Scorpion160/Electronic-Development-board/figures/pcb_face_top.png

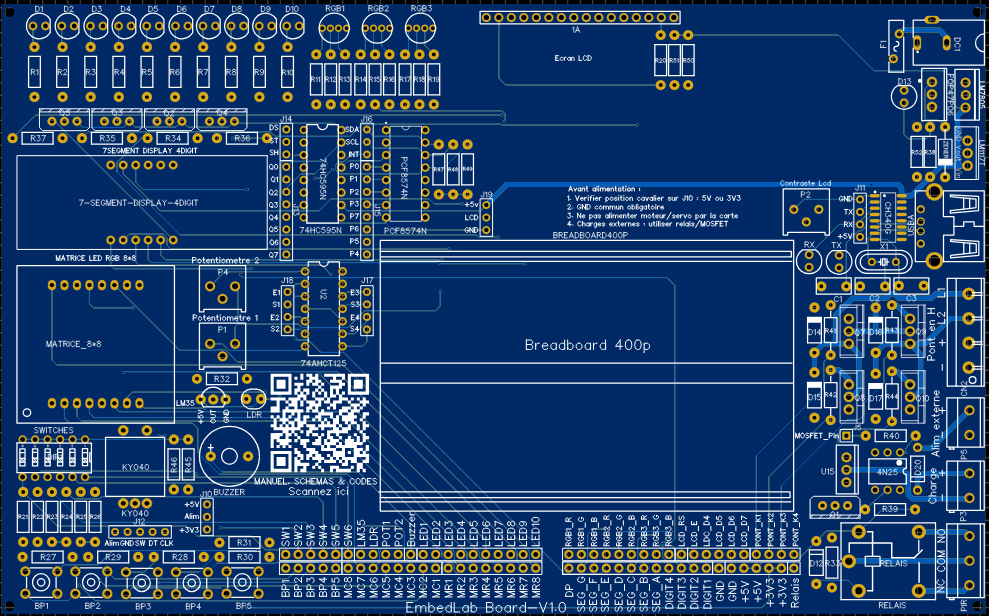
figures/pcb_face_top.png
