Scorpion160/Electronic-Development-board/figures/schema_pcb.png

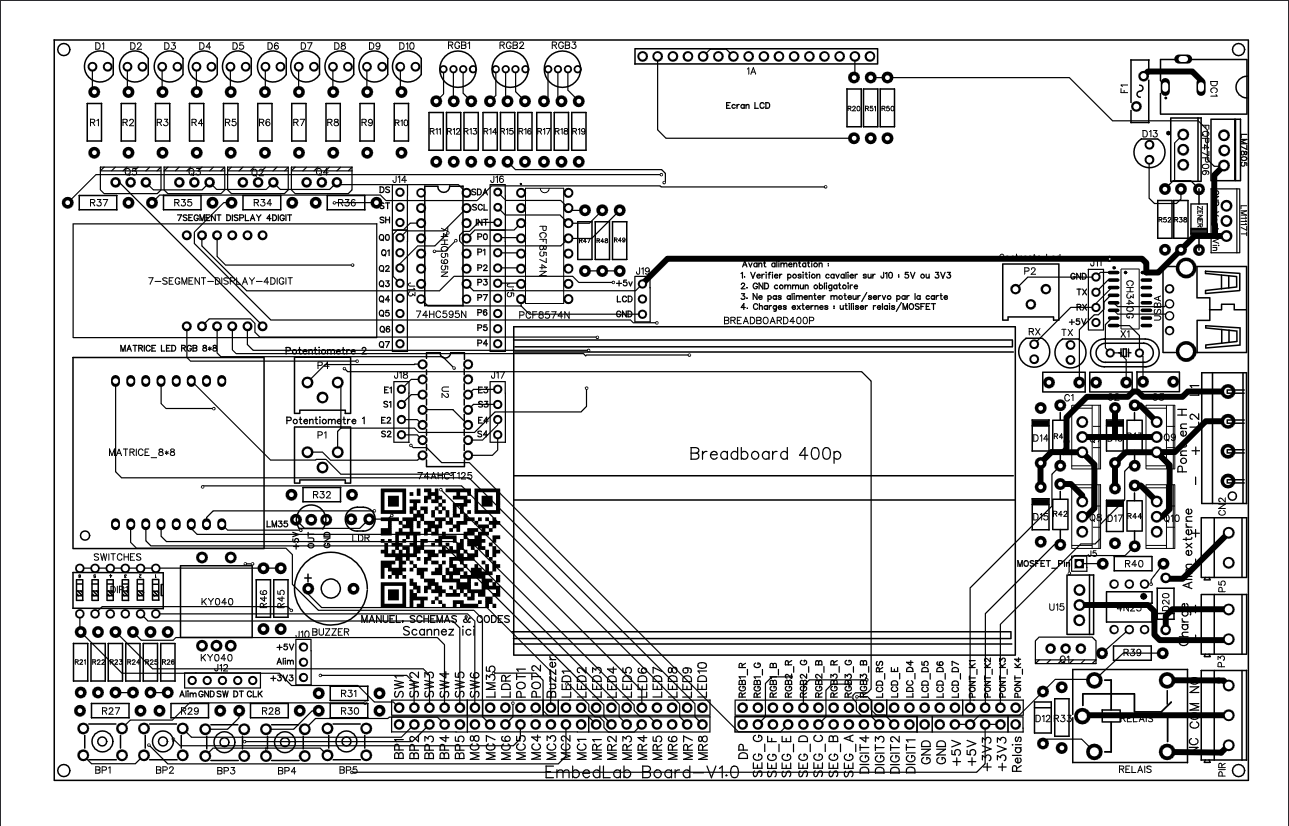
figures/schema_pcb.png
