Scorpion160/Electronic-Development-board/figures/vue_3d_non_annotee.png

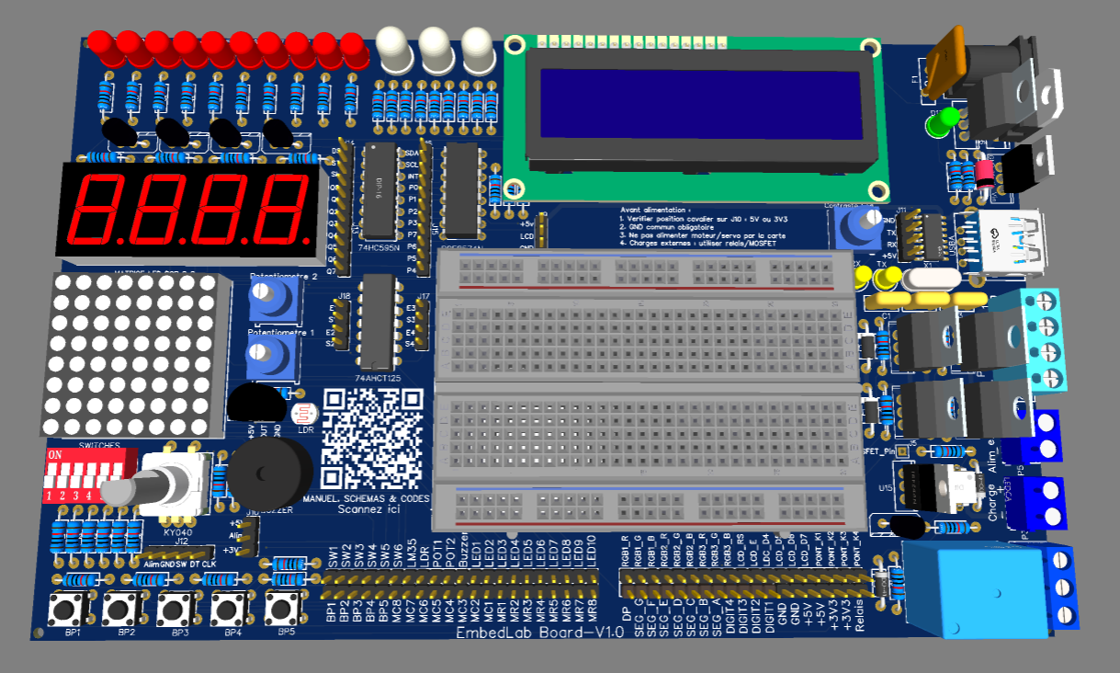
figures/vue_3d_non_annotee.png
