Scorpion160/Electronic-Development-board/render/datasheet-1.png

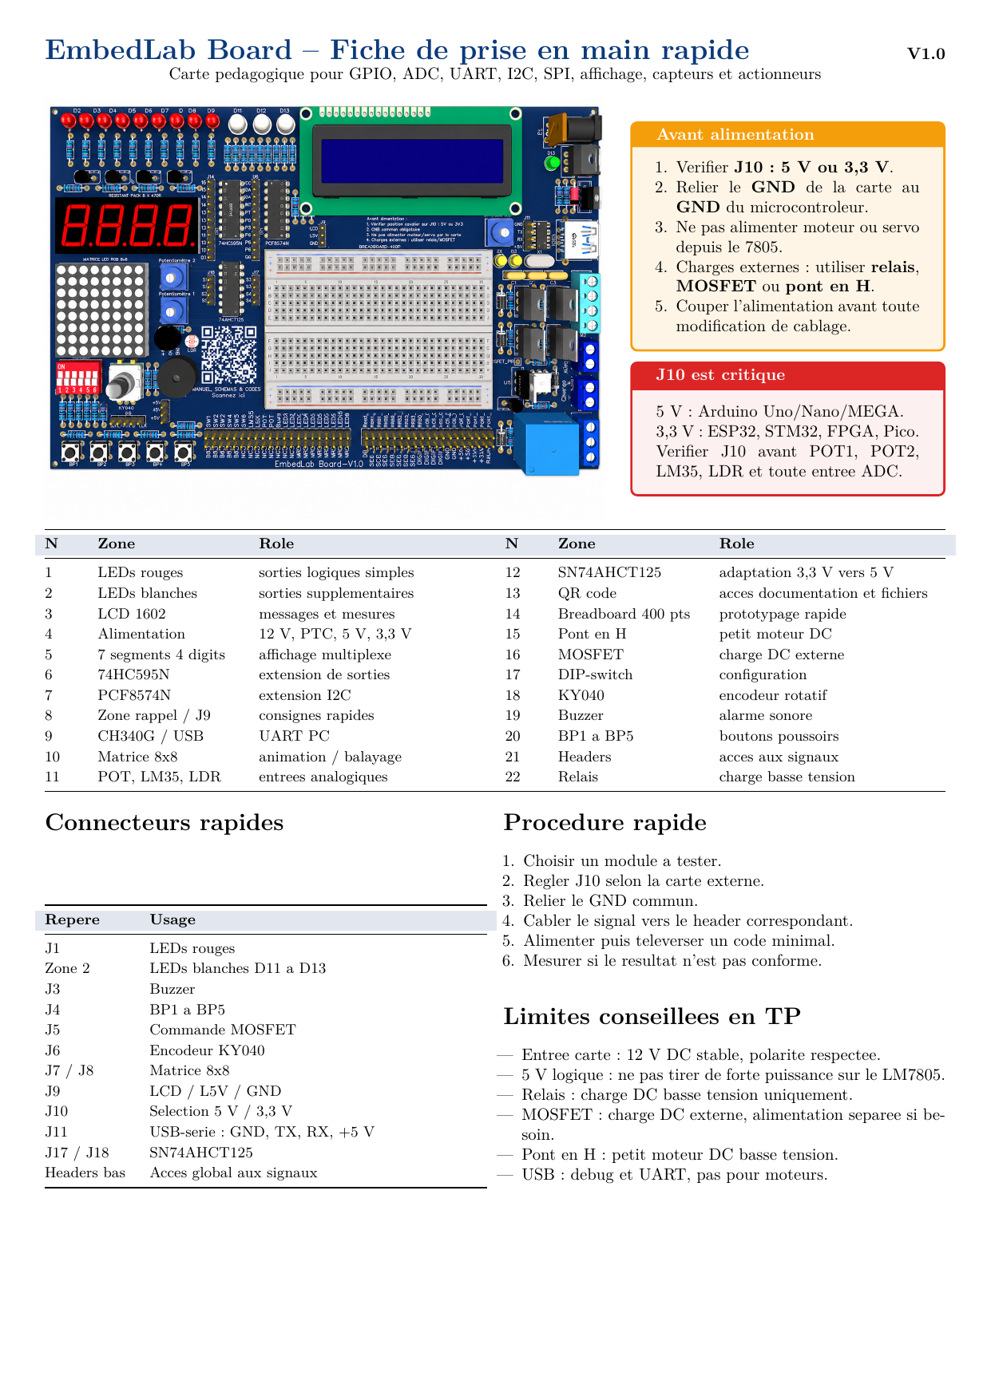
render/datasheet-1.png
