Scorpion160/Electronic-Development-board/render/datasheet-2.png

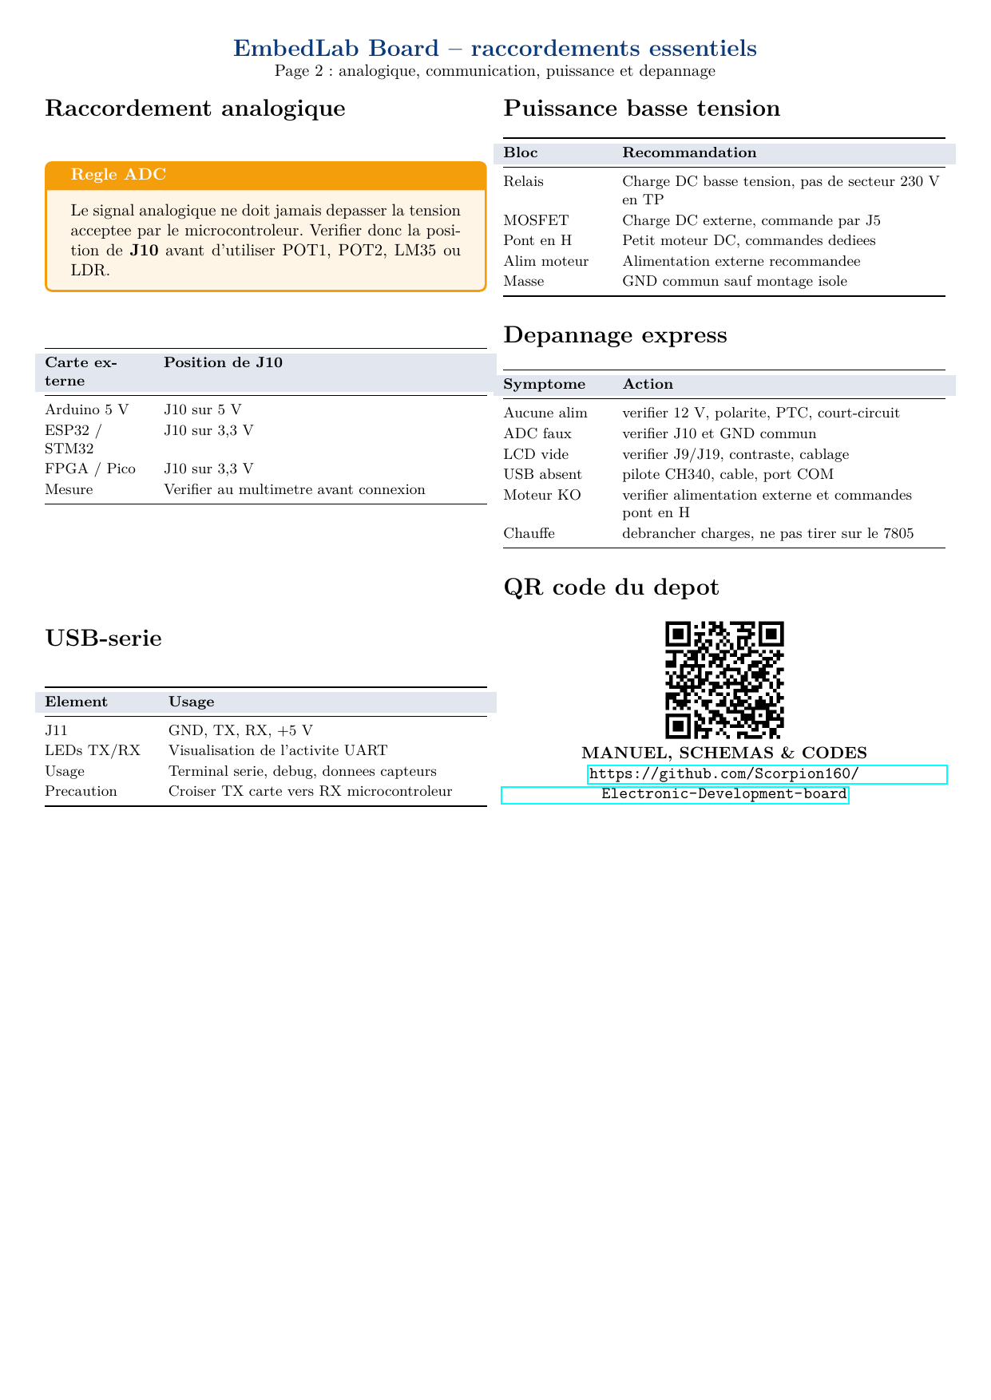
render/datasheet-2.png
