Scorpion160/Electronic-Development-board/hardware/bom/BOM_Carte-de-developpement_2026-06-07.csv

ID | Name | Designator | Footprint | Quantity | Manufacturer Part | Manufacturer | Supplier | Supplier Part | Price | Pins | 3DModel | Add into BOM | Assembly Type | Contributor | Convert to PCB | JLCPCB Part Class | LCSC Assembly | Package Display | Paste Type | SMT Type | Value | Voltage | description | image | license | link
1 | sn74ahct125 | U2 | SN74AHCT125 | 1 |  |  |  |  |  | 14 | SN74AHCT125N/3D/SN74AHCT125N |  |  | jlozon
2 | RGB1 | RGB1 | LED RGB 5MM (ARL5RGB) | 1 |  |  |  |  |  | 4 | LED_D5.0mm-4_RGB |  |  | lehanedonater
3 | RGB2 | RGB2 | LED RGB 5MM (ARL5RGB) | 1 |  |  |  |  |  | 4 | LED_D5.0mm-4_RGB |  |  | lehanedonater
4 | RGB3 | RGB3 | LED RGB 5MM (ARL5RGB) | 1 |  |  |  |  |  | 4 | LED_D5.0mm-4_RGB |  |  | lehanedonater
5 | LED power | D13 | LED_GREEN 5MM | 1 |  |  |  |  |  | 2 |  |  |  | apps1974z
6 | ZL-DCY12075-2705P-7.6 | BUZZER | BUZZER-R6.0-2P-7.6MM | 1 | ZL-DCY12075-2705P-7.6 | ZLFY | LCSC | C194535 | 0.36 | 2 | Buzzer_Beeper.3dshapes/MagneticBuzzer_ProSignal_ABT-410-RC |  |  | jverban
7 | MATRICE_LED_RGB_8*8 | MATRICE_8*8 | MATRICE_8*8 | 1 |  |  |  |  |  | 16 | 8X8 LED MATRIX 3D |  |  | Immelmann75
8 | Led_RED | D1,D2,D3,D4,D5,D6,D7,D8,D9,D10 | LED_GREEN 5MM | 10 |  |  |  |  |  | 2 | LED-TH-5MM_RED |  |  | apps1974z
9 | RX_LED | RX | LED_GREEN 5MM | 1 |  |  |  |  |  | 2 | led-yellow-th |  |  | apps1974z
10 | TX_LED | TX | LED_GREEN 5MM | 1 |  |  |  |  |  | 2 | led-yellow-th |  |  | apps1974z
11 | 12MHz | X1 | HC-49S_L11.5-W4.7-P4.88 | 1 | H1OEL89CSC-SUGYLC-12M | YXC(扬兴晶振) | LCSC | C7471636 | 0.083 | 2 | HC-49S_L11.5-W4.7-P4.88 |  |  | lcsc |  | Extended Part |  |  |  |  |  |  |  |  |  | https://atta.szlcsc.com/upload/public/pdf/source/20210508/C1669874_64E549CF07F5086D89FFFF9B4EA95FB8.pdf
12 | 220 | R50,R51,R1,R2,R3,R4,R5,R6,R7,R8,R9,R10,R11,R12,R17,R20,R38,R40 | RESISTANCE | 18 |  |  |  |  |  | 2 |  |  |  | Shraifk
13 | 4N25 | 4N25 | 4N25-OPTO | 1 |  |  |  |  |  | 6 |  |  |  | patpiz
14 | 7-SEGMENT-DISPLAY-4DIGIT | 7-SEGMENT-DISPLAY-4DIGIT | 7-SEGMENT-DISPLAY-4DIGIT | 1 |  |  |  |  |  | 12 | 4-digit-7segment-display |  |  | supinder1788
15 | button6*6*8 | BP1,BP2,BP3,BP4,BP5 | KEY-TH_4P-L6.0-W6.0-P4.50-LS7.5 | 5 | button6*6*8 | ReliaPro | LCSC | C59982 |  | 4 | KEY-TH_4P-L6.0-W6.0-H4.5-LS6.5-P4.5 |  |  | lcsc |  | Extended Part |  |  |  |  |  |  |  |  |  | https://lcsc.com/product-detail/Tactile-Switches_Made-in-China-6-6-4-5mm_C18818.html
16 | CH340G | CH340G | SOIC-16_L9.9-W3.9-P1.27-LS6.0-BL | 1 | CH340G | WCH(南京沁恒) | LCSC | C14267 | 0.566 | 16 | SOIC-16_L9.9-W3.9-H1.8-LS6.0-P1.27 |  |  | lcsc |  | Extended Part |  |  |  |  |  |  |  |  |  | http://datasheet.octopart.com/MC14076BDR2G-ON-Semiconductor-datasheet-608107.pdf
17 | KY040 | KY040 | KY040 | 1 | KY040 |  |  |  |  | 5 | KY040 |  |  | asher.msk
18 | PCF8574N | PCF8574N | PDIP-16_L19.3-W6.4-P2.54-LS7.9-BL | 1 | PCF8574N | TI(德州仪器) | LCSC | C2879047 | 3.327 | 16 | PDIP-16_L19.3-W6.4-P2.54-LS7.9-BL |  |  | LCSC |  | Extended Part |  |  |  |  |  |  |  |  |  | https://www.ti.com/cn/lit/ds/symlink/cd74hct112.pdf?ts=1642674625836
19 | SRD-DC5V-SL-C | RELAIS | RELAY-TH_SRD-DCXXV-SL-C | 1 | SRD-DC5V-SL-C | null | LCSC | C688865 |  | 5 | RELAY-TH_L19.2-W15.6-H15.8 |  |  | LCSC |  | Extended Part |  |  |  |  |  |  |  |  |  | https://item.szlcsc.com/721972.html
20 | Breadboard 400 | BREADBOARD400P | BREADBOARD 400P | 1 | Breadboard 400p |  |  |  |  |  | breadboard_350_pos_asm |  |  | Rezerv
21 | LDR | LDR | LDR (LDRSC058S) | 1 |  |  |  |  |  | 2 | R_LDR_5.0x4.1mm_P3mm_Vertical |  |  | hasbifajrul03
22 | LM35 | LM35 | LM35 TEMPERATURE SENSOR | 1 |  |  |  |  |  | 3 | LM35DZ |  |  | shastriaaditya
23 | 1N4007 | D20,D12 | DO-41_BD2.4-L4.7-P8.70-D0.9-RD | 2 | 1N4007 | ST(先科) | LCSC | C106903 | 0.02 | 2 | DO-41_D2.4-L4.7-P8.70 |  |  | lcsc |  | Extended Part |  |  |  |  |  |  |  |  |  | https://item.szlcsc.com/85412.html
24 | IRFZ44N | U15 | IRFZ44N | 1 | IRFZ44N | minos(迈诺斯) | LCSC | C7429904 | 0.218 | 3 | irfz44n |  |  | lcsc |  | Extended Part
25 | ZENER | D19 | ZENER | 1 |  |  |  |  |  | 2 | Diode_Zener_1W |  |  | gruni |  |  |  |  |  |  |  |  | Zener Diode
26 | FQP47P06 | FQP47P06 | FQP47P06_THT_3P | 1 | FQP47P06 | ON Semicon | LCSC | C462765 | 3.179 | 3 | FQP47P06 |  |  | LCSC
27 | 100k | R52 | RESISTANCE | 1 |  |  |  |  |  | 2 |  |  |  | Shraifk
28 | LCD 1602 | 1A | HDR-TH_16P-P2.54-V-M | 1 | PZ2.54-1*16 | ZHOURI(洲日) | LCSC | C5360903 | 0.089 | 16 | LCD-TH_LCD-1602-2X16-BLUE-WHITE |  |  | mbj047
29 | Moteur | CN2 | CONN-TH_4P-P5.00 | 1 | 5EHDV-04P | Dinkle | LCSC | C183517 |  | 4 | CONN-TH_4P-P5.00_C9900253432 |  |  | boonchuan khongsupsinsiri |  | Extended Part
30 | load power | P5 | CONN-TH_2P-P5.00 | 1 |  |  | LCSC |  |  | 2 | CONN-TH_2P-P5.00_DB301V-5.0-2P-BU-P |  |  | jobin john
31 | CONN-TH_3P-P5.00 | PIR | CONN-TH_3P-P5.00 | 1 |  |  | LCSC |  |  | 3 | CONN-TH_3P-P5.00 |  |  | denis_13 |  |  |  |  |  |  |  |  |  |  |  | https://www.szlcsc.com/?ref=editor
32 | LM1117T | LM1117T | MY LM1117T | 1 | LM1117T-3.3/NOPB | Texas Instruments | LCSC | C201726 | 2.587 | 3 | User Library-LM1117T |  |  | dkaiss
33 | PJ-102AH_C3096093 | DC1 | DC-IN-TH_PJ-102AH | 1 | PJ-102AH | CUI | LCSC | C3096093 | 1.111 | 3 | DC-IN-TH_PJ-102AH |  |  | lcsc |  | Extended Part |  |  |  |  |  |  |  |  |  | https://cn.bing.com/search?q=datasheet： PJ-102AH
34 | Pot3 | P2 | POTENTIOMETER BLUE | 1 |  |  |  | C61836 |  | 3 | potentiometre 100k | Yes |  | p243528 | Yes |  |  |  |  |  | Potentiometer
35 | load | P3 | CONN-TH_2P-P5.00 | 1 |  |  | LCSC |  |  | 2 | CONN-TH_2P-P5.00_DB301V-5.0-2P-BU-P COPY |  |  | jobin john
36 | DIP SWITCH 6P | DIP1 | DIP SWITCH 6 SWITCHES | 1 | DIP switchEI-08 | DIP | LCSC | C90019 | 0.836 | 12 | DIPSWITCH6 |  |  | OskarNoriyuki
37 | Pot2 | P1 | POTENTIOMETER BLUE | 1 |  |  |  | C61836 |  | 3 | potentiometre 100k | Yes |  | p243528 | Yes |  |  |  |  |  | Potentiometer
38 | Pot1 | P4 | POTENTIOMETER BLUE | 1 |  |  |  | C61836 |  | 3 | potentiometre 100k | Yes |  | p243528 | Yes |  |  |  |  |  | Potentiometer
39 | 5V/3V3 | J10,J16 | HDR-M-2.54_1X3 | 2 |  |  | LCSC | C180248 | 0.226 | 3 | HDR-M-2.54_1x3 |  |  | gilangfajrul
40 | Header source | P8 | HDR-M-2.54-1X6 | 1 | Female header 1*6p | BOOMELE | SCOT-Thai | C40877 | 0.088 | 6 | HDR2.54-M-LI-1X6P |  | manualWeld | tapana1 |  |  | Yes |  | expand | Extend
41 | Header Relay | 10K1 | HDR-M-2.54_1X1 | 1 |  |  | LCSC | C81276 | 0.013 | 1 | HDR-M-2.54_1x1 |  |  | ryanjameshardymail
42 | 1N4007 | D14,D15,D16,D17 | 1N4007 | 4 | 1N4007 | LRC |  | C78540 |  | 2 | DO-41_BD2.4-L4.7-P8.70-D0.9-RD |  |  | PratikPatel |  |  |  |  |  |  |  |  |  | //image.lceda.cn/szlcsc/C78540.jpg
43 | Header 7 seg 4 digt | H1 | HDR-M-2.54-1X12 | 1 |  |  |  |  |  | 12 | HDR-M-2.54_1X12 |  |  | faridrokz
44 | Header LED | J1 | HDR-M-2.54_1X10 | 1 |  |  | LCSC | C57369 | 0.071 | 10 | HDR-M-2.54_1x10 |  |  | Mahedi Hassan
45 | Header LED RGB | J2 | HDR-M-2.54_1X9 | 1 |  |  | LCSC | C225484 | 0.167 | 9 | HDR-M-2.54_1x9 |  |  | Mahedi Hassan
46 | Header Buzzer | J3 | HDR-M-2.54_1X1 | 1 |  |  | LCSC | C81276 | 0.013 | 1 | HDR-M-2.54_1x1 |  |  | Davetech
47 | Header mosfet | J5 | HDR-M-2.54_1X1 | 1 |  |  | LCSC | C81276 | 0.013 | 1 |  |  |  | Davetech
48 | Header BP | J4 | HDR-M-2.54_1X5 | 1 |  |  | LCSC | C358687 | 0.032 | 5 | HDR-M-2.54_1x5 |  |  | malimelukavya
49 | Header pont en H | J6 | HDR-M-2.54_1X4 | 1 |  |  | LCSC | C124378 | 0.055 | 4 | HDR-M-2.54_1x4 |  |  | obadamf
50 | Header Analog | J9 | HDR-M-2.54_1X4 | 1 |  |  | LCSC | C124378 | 0.055 | 4 | HDR-M-2.54_1x4 |  |  | BESTPHOTO
51 | Header Row | J7 | HDR-M-2.54_1X8 | 1 |  |  | LCSC | C190820 | 0.074 | 8 | HDR-M-2.54_1x8 |  |  | alaminkabir.eee18
52 | Header Col | J8 | HDR-M-2.54_1X8 | 1 |  |  | LCSC | C190820 | 0.074 | 8 | HDR-M-2.54_1x8 |  |  | alaminkabir.eee18
53 | Header LCD | P6 | HDR-M-2.54-1X6 | 1 | Female header 1*6p | BOOMELE | SCOT-Thai | C40877 | 0.088 | 6 | HDR2.54-M-LI-1X6P |  | manualWeld | tapana1 |  |  | Yes |  | expand | Extend
54 | Header switch | P7 | HDR-M-2.54-1X6 | 1 | Female header 1*6p | BOOMELE | SCOT-Thai | C40877 | 0.088 | 6 | HDR2.54-M-LI-1X6P |  | manualWeld | tapana1 |  |  | Yes |  | expand | Extend
55 | 2N2222 | Q1,Q2,Q3,Q4,Q5 | TO220-TRANSISTOR | 5 | 2N2222A | ST(先科) | LCSC | C118536 | 0.037 | 3 | 2N2222 wide |  |  | LCSC |  | Extended Part |  | No
56 | TIP41A | Q7,Q8,Q9,Q10 | TO-220 | 4 |  |  |  |  |  | 3 | TIP41C COPY |  |  | KiCAD |  |  |  |  |  |  |  |  | Complementary Silicon Plastic Power Transistor, 3-Pin TO-220, Tube |  | https://www.gnu.org/licenses/lgpl-2.1.html
57 | 470 | R13,R14,R15,R16,R18,R19 | RESISTANCE | 6 |  |  |  |  |  | 2 |  |  |  | Shraifk
58 | 10k | R21,R22,R23,R24,R25,R26,R27,R28,R29,R30,R31,R32,R39,R45,R46 | RESISTANCE | 15 |  |  |  |  |  | 2 |  |  |  | Shraifk
59 | 1k | R33,R34,R35,R36,R37,R47,R48,R49 | RESISTANCE | 8 |  |  |  |  |  | 2 |  |  |  | Shraifk
60 | 220 | R41,R42,R43,R44 | RESISTANCE P4 TR | 4 |  |  |  |  |  | 2 | R_AXIAL-0.4 |  |  | alexisltrn12
61 | LM7805 | U1 | FOOTPRINT-LM7805 | 1 | LM7805 |  | LM | LM7805 |  | 3 | TO-220-3_L10.2-W4.5-P2.55-L |  |  | thirasak281041
62 | 0.1uF | C1 | 0.1UF,100V,(F5XL5XT3.3) | 1 |  | AVX | Mouser | 581-SR211C104KARTR1 |  | 2 | Condensateur 0.1µ |  |  | Varadha_Eda |  |  |  |  |  |  |  | 100V
63 | 22pF | C2,C3 | 0.1UF,100V,(F5XL5XT3.3) | 2 |  | AVX | Mouser | 581-SR211C104KARTR1 |  | 2 | Condensateur 0.1µ |  |  | Varadha_Eda |  |  |  |  |  |  |  | 100V
64 | USB_Type_A/F90°(14.1) | USBA | USB_TYPE_A_TH_USB-M-1 | 1 | USB A/F90°(14.1) | ValuePro | LCSC | C2344 | 0.059 | 6 | USB-A-TH_USB-A-TH_HC-USB3.0-L115-WJ |  |  | sohail.hdesign |  |  |  |  |  |  |  |  |  | //image.lceda.cn/szlcsc/C2344.jpg
65 | Header encodeur rotatif | J12 | HDR-M-2.54_1X5 | 1 |  |  | LCSC | C358687 | 0.032 | 5 | HDR-M-2.54_1x5 |  |  | malimelukavya
66 | Header registre a decalage | J13 | HDR-M-2.54_1X8 | 1 |  |  | LCSC | C190820 | 0.074 | 8 | HDR-M-2.54_1x8 |  |  | alaminkabir.eee18
67 | Header 74hc595 i2c | J15 | HDR-M-2.54_1X8 | 1 |  |  | LCSC | C190820 | 0.074 | 8 | HDR-M-2.54_1x8 |  |  | alaminkabir.eee18
68 | MF-R075 | F1 | FUSE-TH_L10.7-W3.0-P5.08-D1.0-S1.2 | 1 | MF-R075 | BOURNS | LCSC | C208478 | 0.176 | 2 | FUSE-TH_L10.7-W3.0-H15.0-P5.1-D0.8-S1.2 |  |  | LCSC |  | Extended Part |  |  |  |  |  |  |  |  |  | https://list.szlcsc.com/catalog/11042.html
69 | Header alim lcd | J19 | HDR-M-2.54_1X3 | 1 |  |  | LCSC | C180248 | 0.226 | 3 | HDR-M-2.54_1x3 |  |  | gilangfajrul
70 | 74HC595N | 74HC595N | DIP-16_L19.8-W6.5-P2.54-LS7.6-BL | 1 | SN74HC595N | TI(德州仪器) | LCSC | C78711 | 1.622 | 16 | DIP-16_L20.0-W6.4-H3.5-LS7.62-P2.54 |  |  | lcsc |  | Extended Part |  |  |  |  |  |  |  |  |  | https://item.szlcsc.com/580923.html
71 | Header usb_serie | J11 | HDR-M-2.54_1X4 | 1 |  |  | LCSC | C124378 | 0.055 | 4 | HDR-M-2.54_1x4 |  |  | obadamf
72 | Header 74HC595N | J14 | HDR-M-2.54_1X3 | 1 |  |  | LCSC | C180248 | 0.226 | 3 | HDR-M-2.54_1x3 |  |  | gilangfajrul
73 | conv_3v3vers5v_2 | J17,J18 | HDR-M-2.54_1X4 | 2 |  |  | LCSC | C124378 | 0.055 | 4 | HDR-M-2.54_1x4 |  |  | obadamf
