Scorpion160/Electronic-Development-board/hardware/bom/liste_composants_embedlab_5_cartes.xlsx

EmbedLab Board - liste des composants pour 5 cartes
N° | Nom du composant | Référence / valeur | Spécificités | Qté / carte | Qté pour 5 cartes | Liens
1 | Circuit logique buffer/level shifter | SN74AHCT125N | DIP-14 / 14 broches, compatible logique 3,3 V vers 5 V | 1 | 5
2 | Registre à décalage | SN74HC595N / 74HC595N | DIP-16, sorties parallèles 8 bits | 1 | 5
3 | Convertisseur USB-série | CH340G | SOIC-16, avec quartz 12 MHz | 1 | 5 | https://external-content.duckduckgo.com/iu/?f=1&ipo=images
4 | Expandeur I/O I2C | PCF8574N | DIP-16 | 1 | 5
5 | Optocoupleur | 4N25 | DIP-6 | 1 | 5
6 | Régulateur 5 V | LM7805 | TO-220, 5 V | 1 | 5
7 | Régulateur 3,3 V | LM1117T-3.3 | TO-220 / boîtier THT, sortie 3,3 V | 1 | 5
8 | Fusible réarmable PTC | MF-R075 | PTC radial, Ihold 0,75 A environ, pas 5,08 mm | 1 | 5
9 | Transistor NPN | 2N2222A | Transistor de commande | 5 | 25
10 | Transistor NPN puissance | TIP41C | TO-220 | 4 | 20
11 | MOSFET canal N | IRFZ44N | TO-220, pour charge DC externe | 1 | 5
12 | MOSFET canal P | FQP47P06 | TO-220, protection/commutation alimentation | 1 | 5
13 | Diode de redressement | 1N4007 | DO-41, diode de roue libre/protection | 6 | 30
14 | Diode Zener | 1N4739A | Zener 1W-9.1V | 1 | 5
15 | Quartz | 12 MHz | HC-49S, pas environ 4,88 mm, pour CH340G | 1 | 5
16 | Résistance | 220 ohms | Traversante 1/4 W, tolérance 5 % | 22 | 110
17 | Résistance | 470 ohms | Traversante 1/4 W, tolérance 5 % | 6 | 30
18 | Résistance | 1 kohm | Traversante 1/4 W, tolérance 5 % | 8 | 40
19 | Résistance | 10 kohms | Traversante 1/4 W, tolérance 5 % | 15 | 75
20 | Résistance | 100 kohms | Traversante 1/4 W, tolérance 5 % | 1 | 5
21 | Condensateur céramique | 100 nF / 0,1 uF | THT, pour découplage | 1 | 5
22 | Condensateur céramique | 22 pF – 50V | THT, pour quartz 12 MHz | 2 | 10
23 | LED rouge | LED 5 mm rouge | THT, pour D1 à D10 | 10 | 50
24 | LED verte | LED 5 mm verte | THT, témoin alimentation | 1 | 5
25 | LED jaune ou verte | LED 5 mm jaune | THT, témoins TX et RX | 2 | 10
26 | LED RGB | LED RGB 5 mm 4 pattes | Type RGB traversant, cathode commune | 3 | 15
27 | Buzzer | ZL-DCY12075-2705P-7.6 | Buzzer actif THT, pas 7,6 mm | 1 | 5
28 | Matrice LED | Matrice LED 8x8 | 16 broches, THT | 1 | 5
29 | Afficheur 7 segments | Afficheur 7 segments 4 digits | 12 broches ; cathode commune | 1 | 5
30 | Afficheur LCD | LCD 1602 | 2 lignes x 16 caractères, interface parallèle 16 broches | 1 | 5
31 | Bouton poussoir | Tact switch 6x6x8 mm | 4 pattes, traversant | 5 | 25
32 | Interrupteur DIP | DIP switch 6 positions | Traversant | 1 | 5
33 | Encodeur rotatif | KY-040 | Encodeur rotatif 5 broches, juste le module pas la carte entiere | 1 | 5
34 | Potentiomètre ajustable | Potentiomètre bleu | 10 kohms pour entrées ADC | 3 | 15 | https://external-content.duckduckgo.com/iu/?f=1&nofb=1
35 | Capteur lumière | LDR | Photo-résistance THT | 1 | 5
36 | Capteur température | LM35 | TO-92, sortie analogique 10 mV par deg C | 1 | 5
37 | Breadboard | Breadboard 400 points | Mini breadboard autocollante 82*54mm | 1 | 5
38 | Connecteur alimentation DC | PJ-102AH | Jack DC femelle THT | 1 | 5 | https://external-content.duckduckgo.com/iu/?f=1&nofb=1
39 | USB type A | USB Type-A femelle 90 deg | Connecteur THT coudé | 1 | 5 | https://external-content.duckduckgo.com/iu/?f=1&nofb=1
40 | Bornier à vis 2 broches | Pas 5,00 mm | Pour charge/alimentation externe ; P3 et P5 | 2 | 10 | https://duckduckgo.com/?q=Bornier+%C3%A0+vis+2+broches&t=newext&atb=v533-1&ia=images&iax=images
41 | Bornier à vis 3 broches | Pas 5,00 mm | Pour connecteur PIR / extension | 1 | 5
42 | Bornier à vis 4 broches | Pas 5,00 mm | Pour sortie moteur CN2 | 1 | 5
43 | Barrette mâle sécable | 2,54 mm, 1x40 | 3 barrettes par carte | 3 | 15
44 | Barrette femelle sécable | - | - | 1 | 5
45 | Sockets 2*8 | - | - | 2 | 10
46 | Sockets 2*7 | - | - | 1 | 5
47 | Sockets 2*3 |  |  | 1 | 5
