Scorpion160/Electronic-Development-board/render/manual-01.png

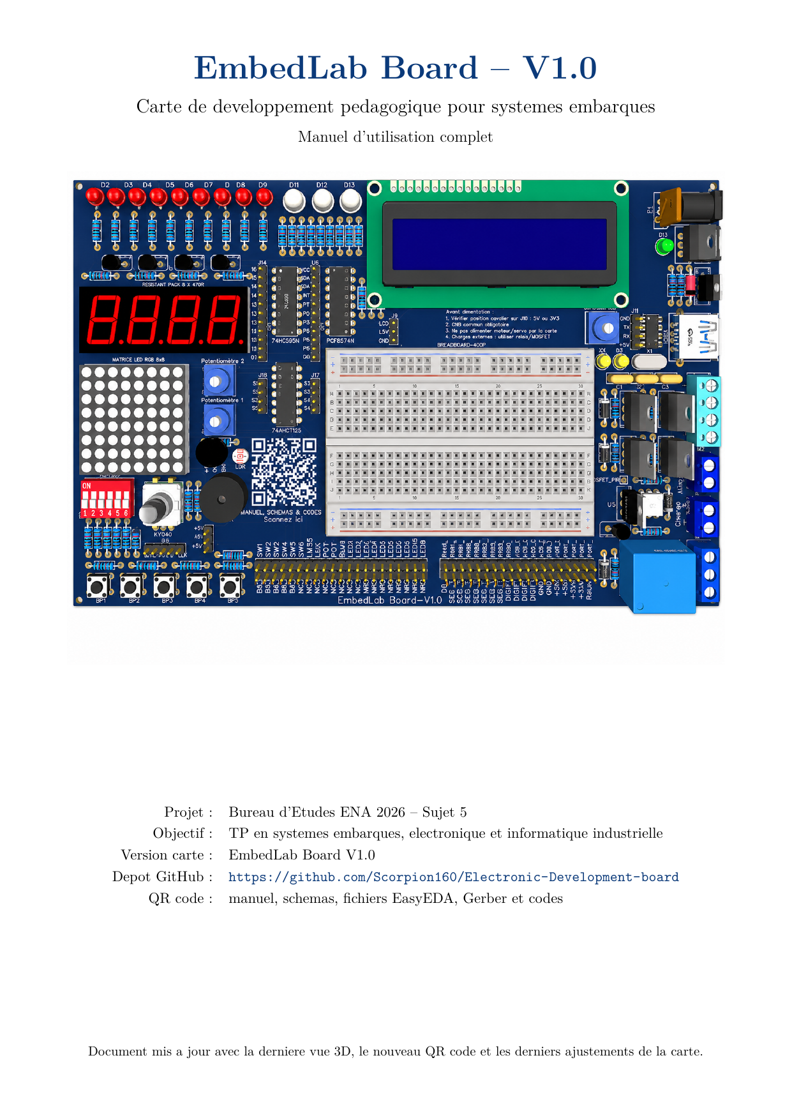
render/manual-01.png
