Scorpion160/Electronic-Development-board/render/manual-02.png

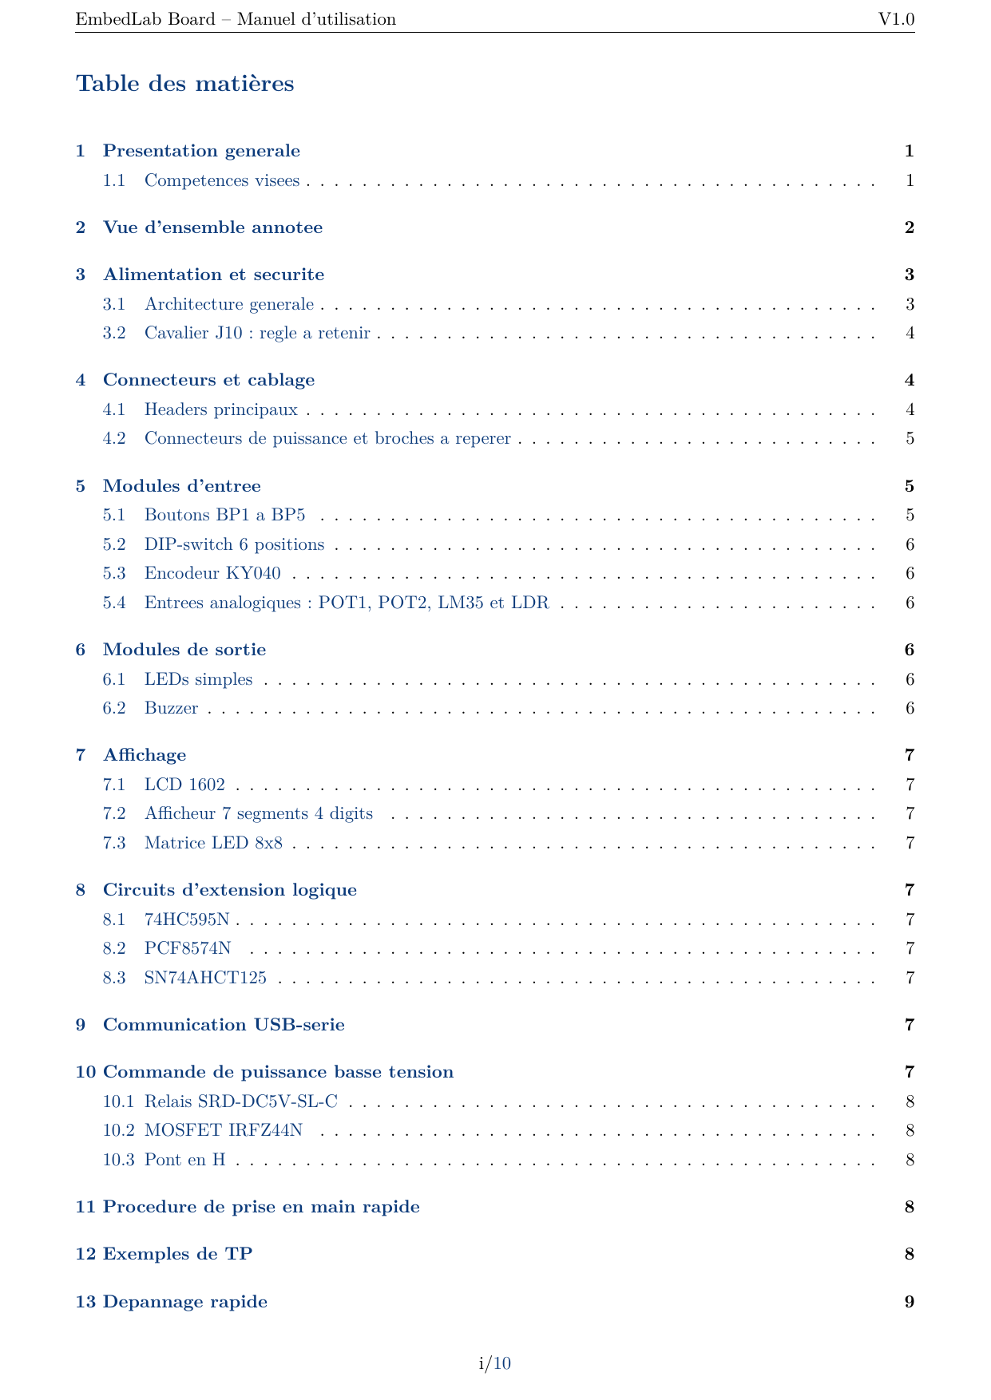
render/manual-02.png
