Scorpion160/Electronic-Development-board/render/manual_more-03.png

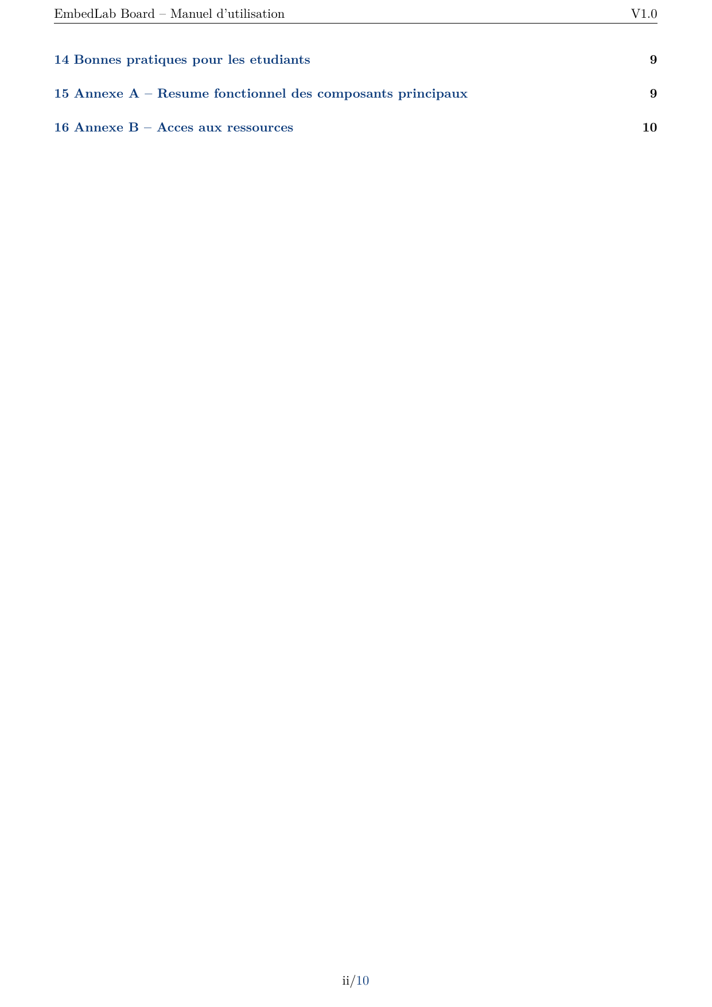
render/manual_more-03.png
