Scorpion160/Electronic-Development-board/render/manual_more-04.png

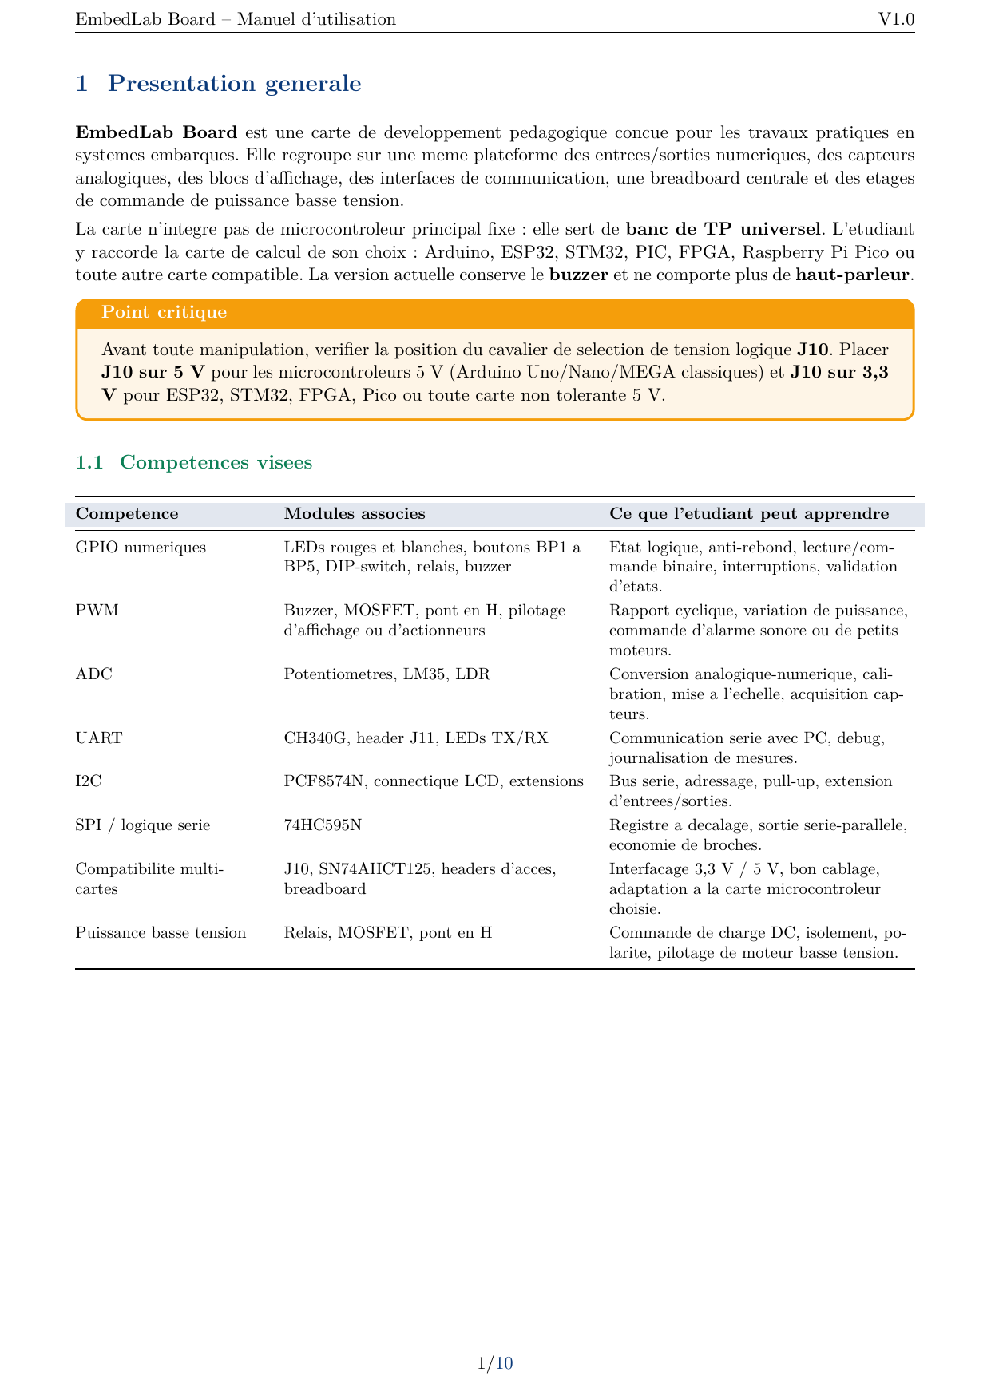
render/manual_more-04.png
