Scorpion160/Electronic-Development-board/render/manual_more-05.png

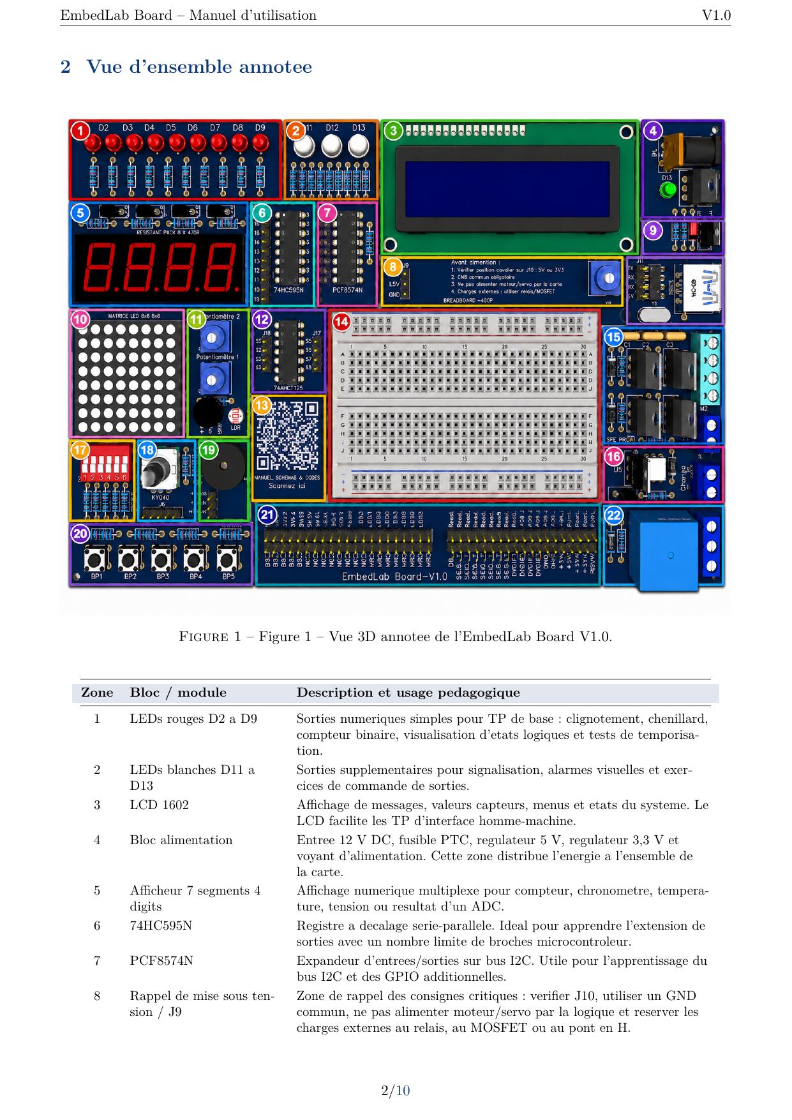
render/manual_more-05.png
