Scorpion160/Electronic-Development-board/render/manual_more-06.png

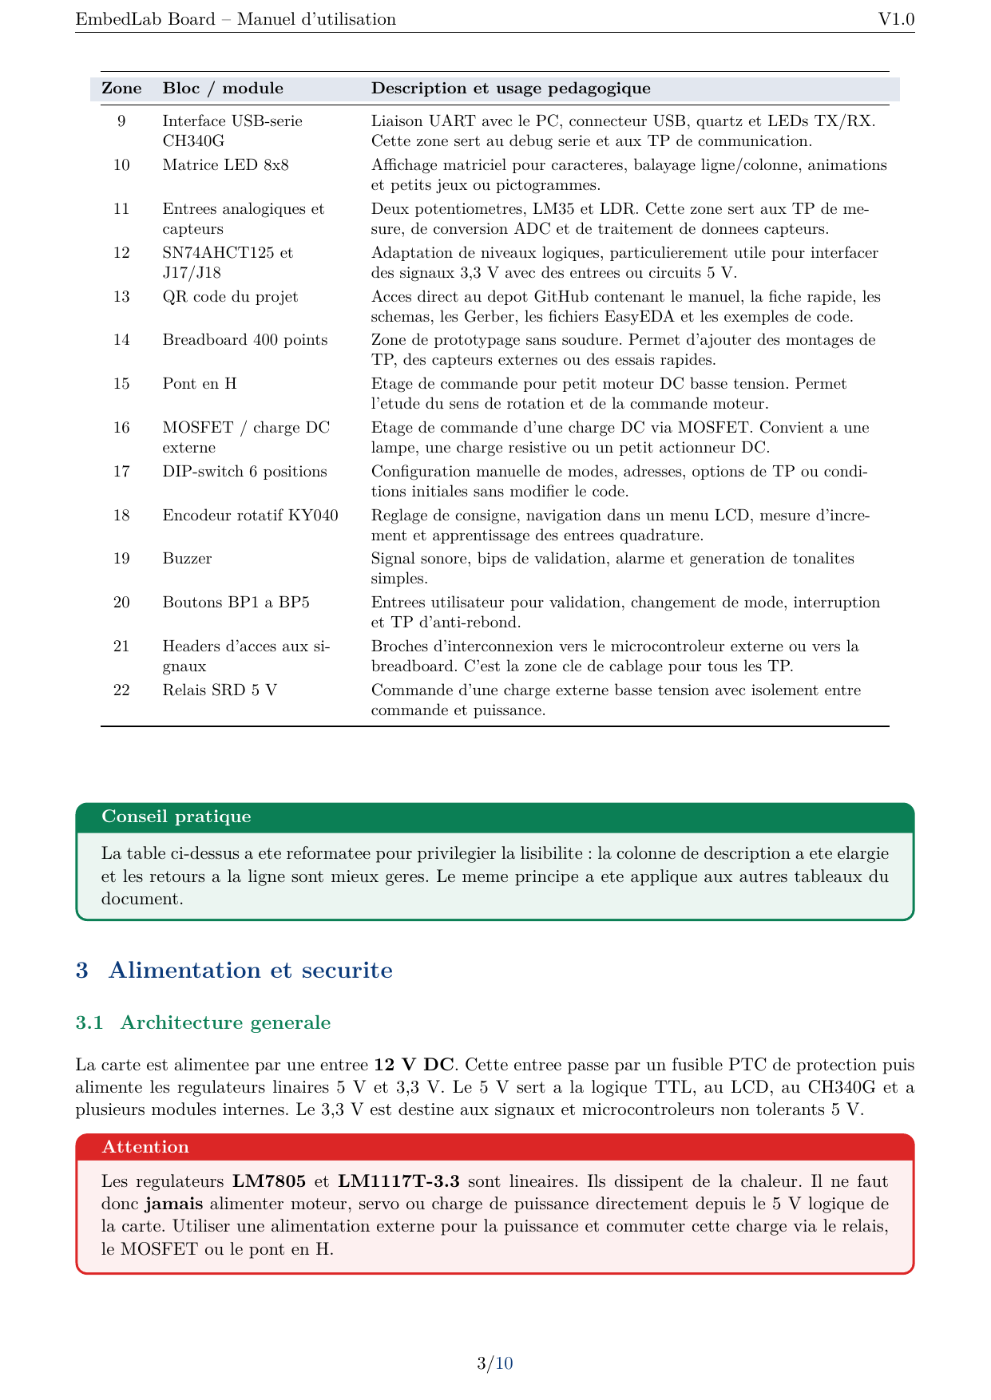
render/manual_more-06.png
