Scorpion160/Electronic-Development-board/(list of files, drawings)

Other design files:
hardware/easyeda/PCB_PCB_Carte-de-developpement_2026-06-07.json
hardware/easyeda/SCH_Carte-de-developpement_2026-06-07.json
