Scorpion160/Electronic-Development-board/(commit log)

2026-06-07 Initial commit - EmbedLab Board documentation and hardware files
    [BOM_Carte-de-developpement_2026-06-07.csv, PCB_PCB_Carte-de-developpement_2026-06-07.json, PickAndPlace_PCB_Carte-de-developpement_2026-06-07.csv, SCH_Carte-de-developpement_2026-06-07.json, liste_composants_embedlab_5_cartes.xlsx]
2026-06-07 Clarify BOM description in README
    Updated the BOM description for clarity.
2026-08-12 Add Arduino serial test agent firmware
2026-08-12 Add pin mappings for EmbedLab tester
2026-08-12 Add pin-aware planning to tester UI
2026-08-12 Document pin-mapping workflow
2026-08-12 Confirm MOSFET command on J5
2026-08-12 Document MOSFET command on J5
2026-08-12 Use confirmed J5 MOSFET pin in tester mappings
2026-08-12 Extend Arduino agent with advanced test commands
2026-08-12 Add advanced module pin mappings
